ZacH005/CPS-LabyrinTUM/calibration/CharUco_2.png

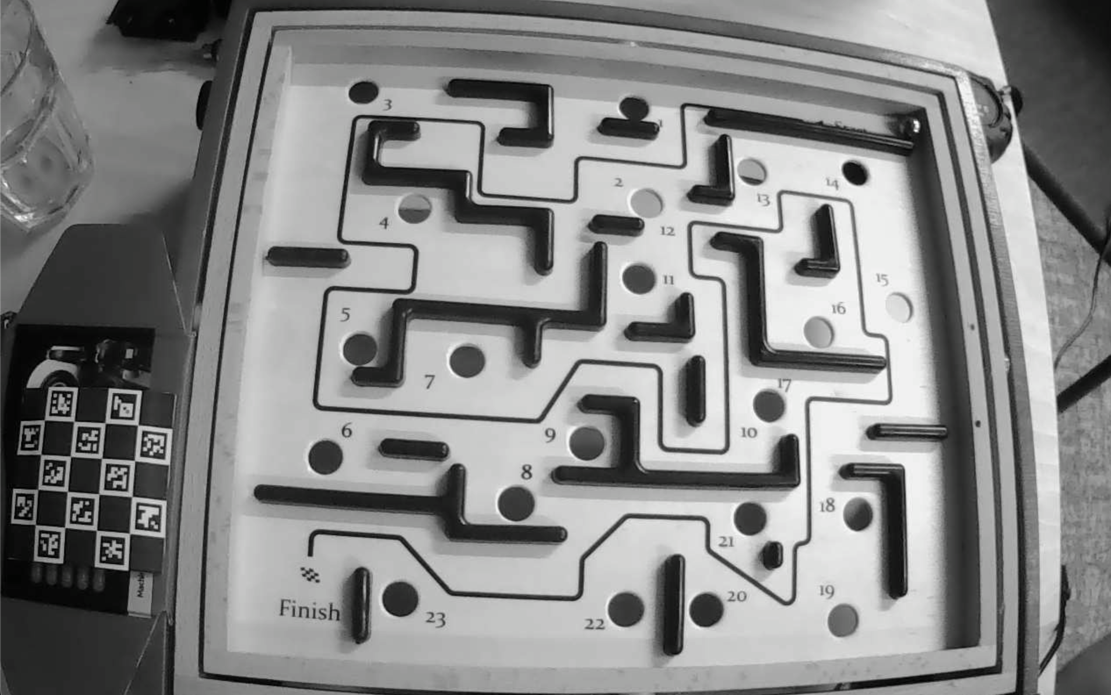
calibration/CharUco_2.png
