ZacH005/CPS-LabyrinTUM/calibration/CharUco_4.png

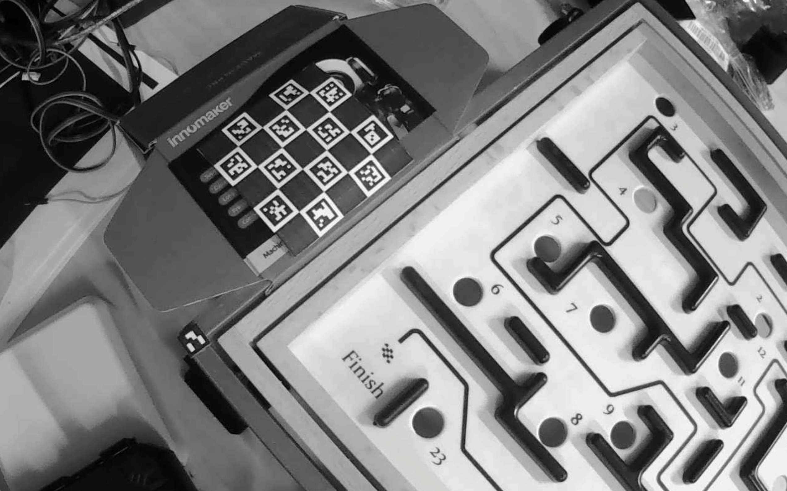
calibration/CharUco_4.png
