ZacH005/CPS-LabyrinTUM/notebooks/README.md

# Notebooks

Use notebooks only for calibration exploration, data analysis, and plotting.

Core runtime logic should live in `src/cps_maze/` so it can be tested and reused by scripts.
