ZacH005/CPS-LabyrinTUM/data/raw/README.md

# Raw Data

Use this folder for raw videos, unmodified camera captures, and first-pass run logs.

Large files should not be committed unless explicitly needed for a small reproducible example.
