ZacH005/CPS-LabyrinTUM/calibration/README.md

# Calibration Files

Store generated calibration files here.

Expected files later:

- `camera_intrinsics.npz` - camera matrix and distortion coefficients.
- `board_homography.npz` - image-to-board coordinate transform.
- `marker_points.csv` - selected image and board reference points.

These generated files are ignored by Git by default because they are machine/setup specific.
