ZacH005/CPS-LabyrinTUM/docs/TUNING_ROADMAP.md

# Moved

This roadmap was merged into the single project roadmap:

**[docs/LIVE_MVP_DEVELOPMENT_ROADMAP.md](LIVE_MVP_DEVELOPMENT_ROADMAP.md)**

Part 1 there records the completed MVP bring-up stages; Part 2 is the active
tuning roadmap (formerly this file), with commands and per-stage success
criteria.
