ZacH005/CPS-LabyrinTUM/calibration/example_marker_points.csv

x_px | y_px | x_mm | y_mm
240.9 | 1495.9 | 0 | 0
634.8 | 1450.3 | 600 | 0
569.1 | 1035.6 | 600 | 600
193.0 | 1094.3 | 0 | 600
