ZacH005/CPS-LabyrinTUM/calibration/refresh_backup_20260711_174203/configs/maze_holes.csv

x_mm | y_mm | radius_mm
209.4 | 204.8 | 4.9
157.9 | 201.0 | 4.9
129.4 | 201.0 | 5.2
55.5 | 198.1 | 4.8
174.5 | 169.9 | 5.6
217.1 | 167.8 | 5.5
90.9 | 167.0 | 5.6
27.6 | 153.8 | 5.1
114.7 | 145.8 | 5.7
183.6 | 129.0 | 5.7
71.7 | 118.0 | 5.5
35.2 | 115.7 | 5.4
206.2 | 99.4 | 5.6
242.1 | 86.8 | 5.4
134.2 | 82.6 | 5.9
50.2 | 61.0 | 5.6
138.1 | 50.9 | 5.8
182.9 | 33.3 | 5.8
228.7 | 29.2 | 5.5
29.7 | 13.7 | 5.4
134.8 | 9.3 | 5.7
