ZacH005/CPS-LabyrinTUM/calibration/refresh_backup_20260711_190709/configs/maze_holes.csv

x_mm | y_mm | radius_mm
207.3 | 200.4 | 5.1
156.9 | 196.4 | 5.2
129.0 | 196.4 | 5.4
56.9 | 193.3 | 5.2
173.0 | 165.9 | 5.5
214.7 | 164.2 | 5.4
91.3 | 162.7 | 5.6
30.2 | 149.2 | 5.4
114.5 | 141.7 | 5.6
181.5 | 125.8 | 5.6
72.7 | 114.9 | 5.6
37.6 | 112.5 | 5.5
203.3 | 96.9 | 5.6
238.2 | 84.9 | 5.5
133.2 | 80.4 | 5.8
52.3 | 59.6 | 5.6
136.9 | 50.0 | 5.8
180.1 | 32.9 | 5.7
224.5 | 29.3 | 5.4
33.0 | 14.7 | 5.5
133.4 | 9.9 | 5.7
