ZacH005/CPS-LabyrinTUM/calibration/refresh_backup_20260711_191825/configs/maze_holes.csv

x_mm | y_mm | radius_mm
206.5 | 198.9 | 5.0
156.7 | 195.1 | 5.2
129.0 | 195.1 | 5.4
57.4 | 192.8 | 5.1
172.9 | 165.2 | 5.4
214.2 | 163.1 | 5.4
91.7 | 162.3 | 5.6
30.4 | 149.4 | 5.4
114.8 | 141.5 | 5.7
181.4 | 125.2 | 5.6
73.2 | 114.8 | 5.5
38.2 | 112.6 | 5.4
203.2 | 96.6 | 5.6
237.9 | 84.5 | 4.9
133.7 | 80.3 | 5.8
53.1 | 59.8 | 5.5
137.6 | 49.8 | 5.7
180.8 | 32.7 | 5.6
224.8 | 29.2 | 5.3
33.7 | 14.6 | 5.4
134.3 | 9.8 | 5.6
