ZacH005/CPS-LabyrinTUM/calibration/refresh_backup_20260711_225427/configs/maze_holes.csv

x_mm | y_mm | radius_mm
204.1 | 201.5 | 5.3
153.8 | 197.3 | 5.5
126.3 | 197.3 | 5.5
55.3 | 193.8 | 5.2
169.8 | 167.8 | 5.6
211.5 | 165.8 | 5.4
88.9 | 164.2 | 5.5
29.8 | 150.5 | 5.1
111.6 | 143.6 | 5.6
178.2 | 128.1 | 5.6
70.7 | 117.2 | 5.4
36.5 | 114.8 | 5.2
199.8 | 99.5 | 5.5
130.1 | 83.3 | 5.6
51.1 | 63.0 | 5.4
134.0 | 53.3 | 5.6
177.0 | 36.1 | 5.6
221.2 | 32.4 | 5.2
32.6 | 18.9 | 5.0
130.6 | 15.0 | 5.1
235.6 | 87.8 | 8.0
