ZacH005/CPS-LabyrinTUM/calibration/Charuco_1.png

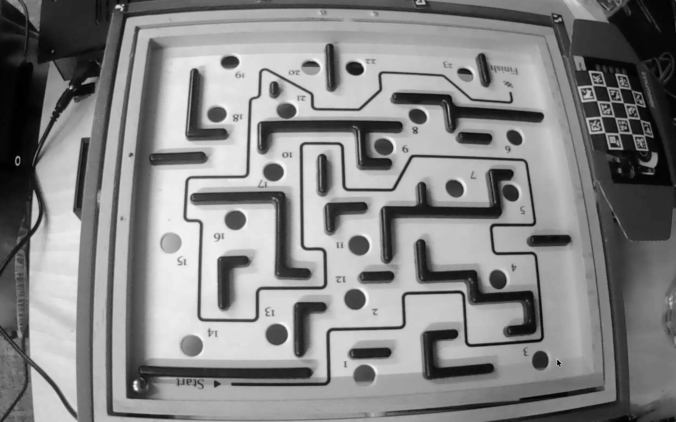
calibration/Charuco_1.png
