ZacH005/CPS-LabyrinTUM/calibration/CharUco_3.png

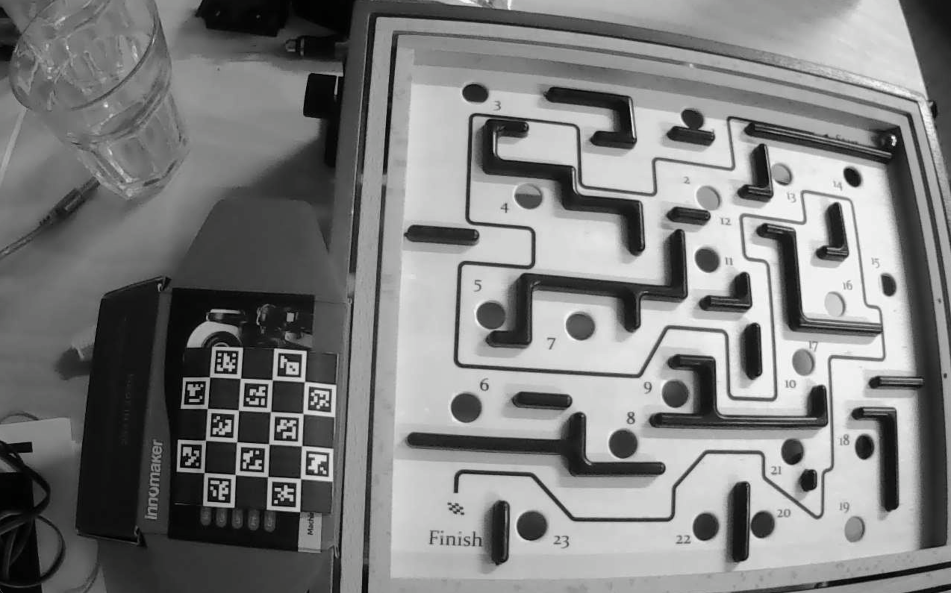
calibration/CharUco_3.png
