ZacH005/CPS-LabyrinTUM/calibration/CharUco_5.png

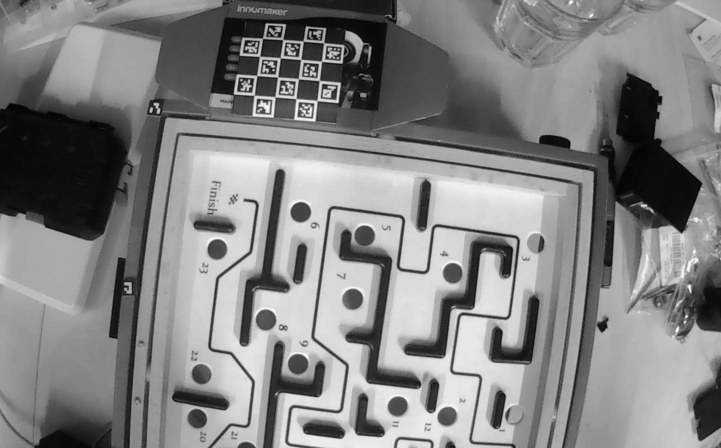
calibration/CharUco_5.png
