ZacH005/CPS-LabyrinTUM/calibration/CharUco_6.png

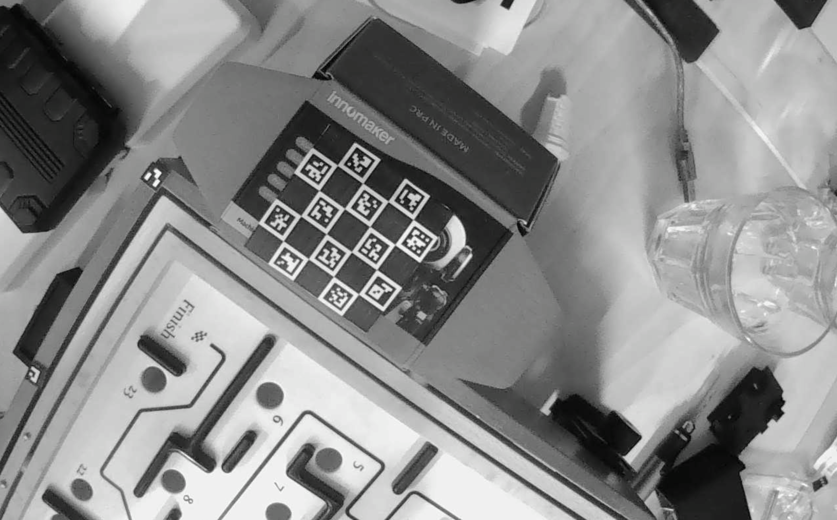
calibration/CharUco_6.png
