ZacH005/CPS-LabyrinTUM/calibration/CharUco_7.png

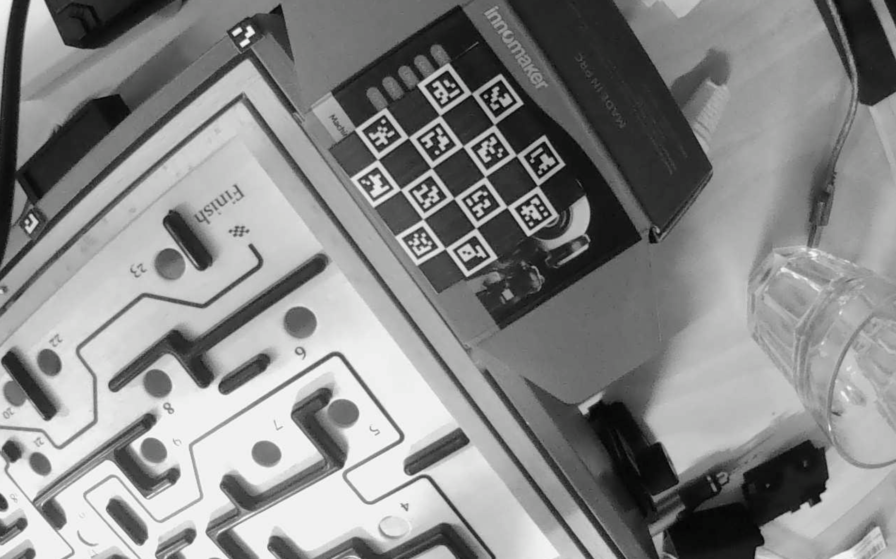
calibration/CharUco_7.png
