ZacH005/CPS-LabyrinTUM/calibration/CharUco_8.png

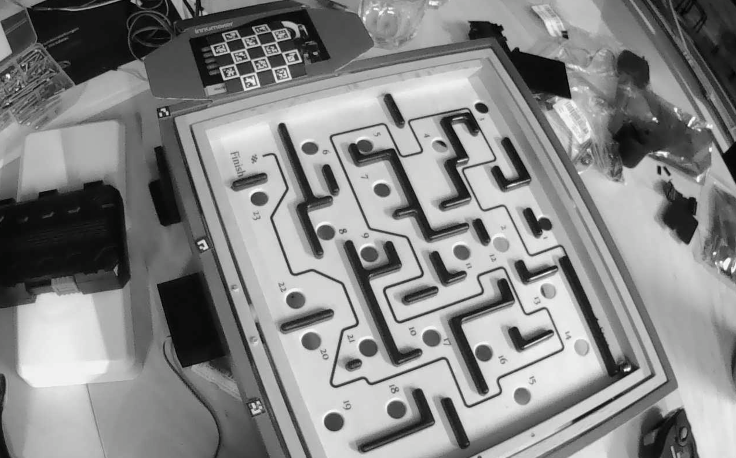
calibration/CharUco_8.png
