ZacH005/CPS-LabyrinTUM/calibration/CharUco_9.png

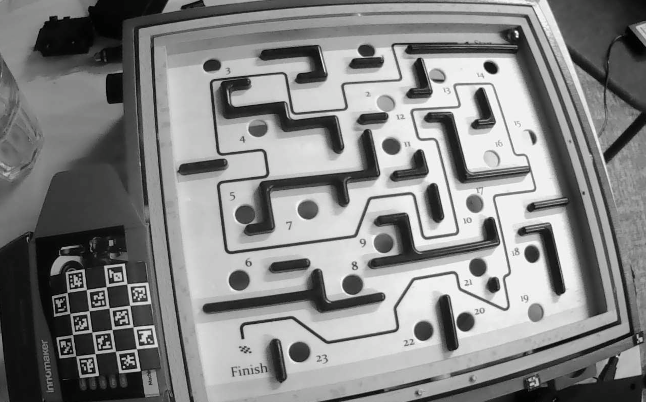
calibration/CharUco_9.png
