ZacH005/CPS-LabyrinTUM/calibration/charuco_board.png

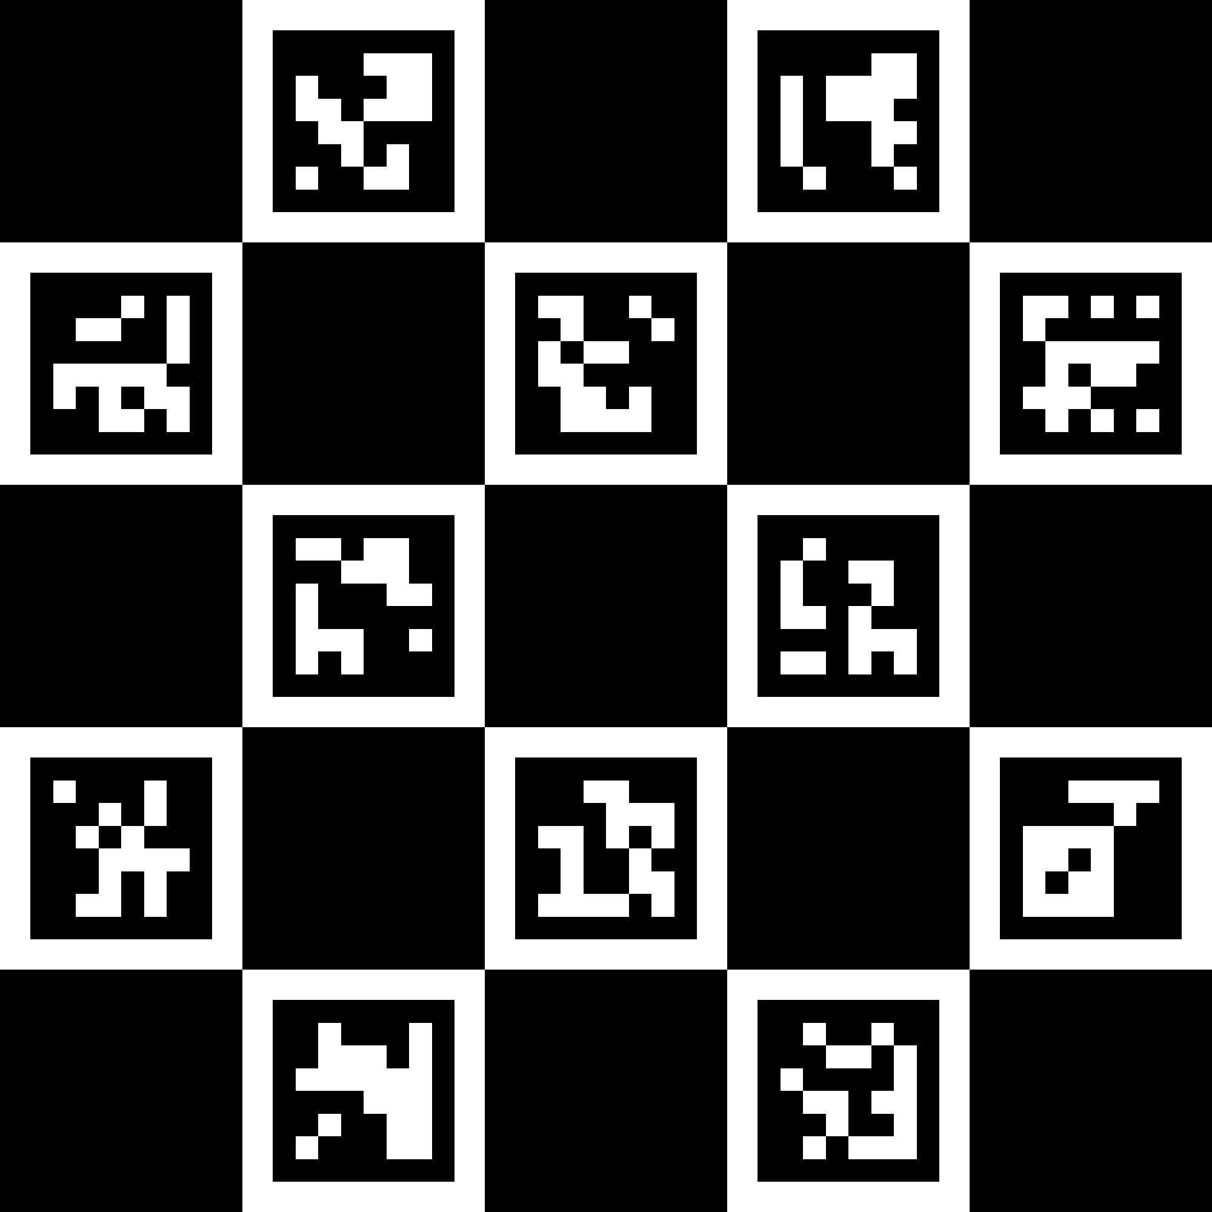
calibration/charuco_board.png
