ZacH005/CPS-LabyrinTUM/(commit log)

2026-06-16 init and repo structure
    [example_marker_points.csv, example_path.csv]
2026-07-04 Update calibration data and add image display script for board calibration
    [example_marker_points.csv]
2026-07-06 Fix ChArUco frame: y-down, flat-on-surface placement, CLI offsets
    - charuco.py: y now grows down, matching the corner-click calibration
    frame, so the two calibrations produce interchangeable coordinates;
    the pattern must lie flat on the play surface (a homography is only
    valid for points in one plane - the old side-platform mount broke it)
    - calibrate_charuco_homography.py: --pattern-x-mm/--pattern-y-mm set
    where the pattern sits relative to the play-area corner; default
    (0,0) anchors the frame at the pattern, still valid for all tools
    - auto_detect_holes.py: draw the board-frame outline and live mm mouse
    readout so the active calibration is visible at a glance
    - tests updated to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
2026-07-07 Fix hole detection inside closed border ring; clip to board bounds
    At high thresholds the board border becomes a closed white ring in the
    mask, and RETR_EXTERNAL drops every contour enclosed by it - exactly
    when dim/gray holes finally become visible. Switch to RETR_LIST (with
    center-distance de-duplication for outer+inner contours of one blob)
    and reject detections outside the board rectangle plus margin, so
    off-board junk from the auto-fit view can no longer appear as holes.
2026-07-09 Update annotated holes and auto-traced path from lab session
    [maze_holes.csv, maze_path_auto.csv]
2026-07-09 Add click-to-seed, cursor brightness readout, and in-pulse tracking
    On the bright white board several glints rival the ball, so auto-seed
    can lock onto a wall reflection and stay there. Fixes:
    - PipelineBallTracker.seed(): manual (re)seed from a user click
    - axis_check: live preview while waiting (click the ball to seed, peak
    brightness shown under the cursor to choose min_specular from real
    pixel values instead of guessing), and frames keep feeding the
    tracker during the servo pulse so the track survives the motion
    - run_autonomous: click the preview at any time to (re)seed the track
2026-07-09 Point maze.path_file at the real traced route, not the scaffold dummy
2026-07-09 Add stiction compensation and integral action to the path follower
    Pure PD has a stable parked equilibrium on this rig: near the target
    the command drops below the tilt that breaks static friction
    (~0.25-0.4 measured via axis_check), so the ball balances and stops -
    observed in the first closed-loop runs. Changes:
    - PathFollower: optional integral term with clamping anti-windup and
    bleed-off at the target, plus a stall kick that scales the command
    up to a minimum magnitude whenever the ball is stalled off-target
    - run_autonomous: passes dt, config/CLI for ki and --stall-kick
    - default.yaml: enable ki=0.004, stall_kick=0.30, lookahead 18mm,
    max_command 0.45 as the new tuned baseline
    -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
    [default.yaml]
2026-07-09 Update holes and path CSVs from lab session
    [maze_holes.csv, maze_path_auto.csv]
2026-07-09 Fix path association snapping to adjacent corridors behind walls
    The maze path snakes, so corridors far apart in path order sit
    millimetres apart physically. Global nearest-segment projection could
    associate the ball with a future/past corridor across a wall, sending
    the lookahead target - and the controller - into the wall between
    them (observed in closed-loop runs).
    WaypointPath now supports windowed projection around the last known
    progress (the ball cannot teleport along the path between frames),
    returning (progress, cross-track). run_autonomous tracks the progress
    estimate, resets it on click-reseed, and falls back to a global search
    when the windowed match is >35mm off-path (ball move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
2026-07-09 Warn when max-command is below stall_kick (kick gets clipped away)
2026-07-09 Add velocity-tracking path follower with corner braking
    Board tilt commands the ball's acceleration, so position-PD cannot
    model momentum: it carries speed into corners (12.7mm overshoot in the
    friction sim) and, with the stall kick, produces jerky bang-bang
    commands - both observed in closed-loop runs (ball thrown into holes,
    board snapping).
    New default controller tracks a desired VELOCITY along the path
    tangent: cruise speed scales down with the path's heading change ahead
    (brakes before corners), a capped lateral term pulls toward the
    centerline, and tilt corrects velocity error - so an over-fast ball
    automatically gets reverse tilt. Stall kick preserved for breakaway.
    - path.py: tange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
    [default.yaml]
2026-07-09 u gay bru
    [maze_holes.csv, maze_path_auto.csv]
2026-07-10 Refactor control system to implement carrot-based path following
    - Updated default.yaml to change control mode to "carrot" and adjusted parameters for improved cornering and velocity control.
    - Introduced CarrotVelocityFollower and associated configurations in pid.py for enhanced path following behavior.
    - Modified run_autonomous.py to support the new carrot mode, including lookahead point selection and command generation.
    - Updated tests to validate the functionality of the carrot follower and its behavior during cornering and stalling conditions.
    - Adjusted maze_holes.csv and maze_path_auto.csv for better alignment with the new control logic.
    [maze_holes.csv, maze_path_auto.csv]
2026-07-10 Add tracking debugger; fix stall-kick jitter with hysteresis + escalation
    Two field issues addressed:
    1. "Loses the ball randomly": the tracker now records per-frame
    diagnostics (candidate counts per cue, rejections per gate, glint
    brightness at the track, template score/rescues). New
    scripts/debug_tracking.py shows them live, logs every track drop
    with its dominant reason, lets min_specular be adjusted live via
    trackbar, and prints an exit report with a data-driven recommended
    threshold (p5 of the ball's real glint minus margin).
    2. "Board jitters but the ball stays balanced": the stall-kick timer
    hard-reset whenever the noisy velocity estimate flickered above the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
    [default.yaml]
2026-07-10 Fix fast-motion ball loss and near-constant corner crawling
    Field findings from the tracking debugger (85% detection, drops on fast
    motion) plus analysis of the real traced path:
    1. Fast motion loss: the control loop runs well below the camera's
    120fps, so a fast roll moves the ball 40-60px between PROCESSED
    frames - past the jump gates tuned in px/frame. Gates widened
    (max_jump 35->60, search 60->120, single-frame 45->90, velocity
    clamp 35->70). The debugger now displays live loop fps and px/frame
    jump, and reports their distribution so gates can be set from data.
    2. Motion blur dims the glint exactly when the ball moves fast
    (observed: 243 static, dips to ~194 moving) -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
    [default.yaml]
2026-07-10 ball detection
    [maze_holes.csv, maze_path_auto.csv]
2026-07-10 Fix the invisible wall: emergency brake only fires for real run-offs
    Field finding: the ball got stuck shaking between two close holes (or
    circling near one) as if behind an invisible wall. Cause: the route
    legitimately threads between holes whose CAPTURE ZONES overlap the
    centerline, so a ball rolling along the route there always "enters a
    capture zone" - the emergency brake fired, the stall kick pushed, the
    brake fired again: a limit cycle that blocks the pass entirely.
    should_emergency_brake() gates the reactive brake: it never fires for a
    ball that is on the route (cross-track <= hole_emergency_offroute_mm)
    and moving along it (velocity within hole_emergency_align_deg of the
    path tangen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
    [default.yaml]
2026-07-11 Replace reactive hole caps with a precomputed route speed profile
    Root cause of the ball 'spazzing' at hole passes (confirmed frame by
    frame in the run replay): where capture zones overlap the route, the
    per-frame hazard cap pinned the crawl speed AT the stall-detection
    threshold (both 8 mm/s), so planned crawling was diagnosed as a stall,
    the kick escalated to ~0.95 and launched the ball to 70+ mm/s, the
    brake slammed it back to zero, repeat - 15 s to travel 19 mm. Three
    locally-correct mechanisms in a global limit cycle.
    The maze is static, so the speed at every point of the route is now
    decided ONCE, coherently (planning/speed_profile.py): local limits per
    sample (committed moderate PASS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
    [default.yaml]
2026-07-11 Enhance control parameters and introduce recovery A* path planning
    - Updated `default.yaml` to adjust control parameters for improved navigation, including increased `min_speed_frac`, `corner_slow_deg`, and modified braking commands.
    - Added new recovery A* path planning functionality in `run_autonomous.py` to assist the ball in navigating off-route situations, with parameters for wall and hole clearance.
    - Implemented logic to handle recovery scenarios based on ball position and speed, enhancing overall robustness in complex environments.
    - Ensured compatibility with existing control mechanisms while improving responsiveness and safety during autonomous runs.
    [default.yaml]
2026-07-11 Warn when the confusers file is contaminated by the ball itself
    Debug session finding: ~100 static confusers blanketing the play area,
    permanently rejecting the ball's own candidates wherever it rolled
    (status lost, miss streak 148). Cause: the confuser-calibration video
    was recorded WITH the ball on the board, so every spot where the ball
    lingered >10% of the recording blacklisted itself.
    The live tracker now warns loudly when an implausible number of
    confusers loads (>30; a healthy board has ~5-15) with the exact
    remediation, and pipeline.py --calibrate documents the no-ball rule.
2026-07-11 Add neutral trim calibration: find the command where the board is level
    The table/frame is slanted, so servo neutral is not a level board: a
    resting ball drifts and the controller wastes integral headroom
    fighting a constant bias all run. The ball itself is now used as the
    level sensor.
    - scripts/calibrate_neutral_trim.py: two phases. Phase 1 nulls the
    drift (measure drift velocity over a window while streaming the
    candidate trim, step against it through the measured axis map,
    repeat until still twice in a row). Phase 2 centers the stiction
    band: friction leaves a whole band of trims where the ball is still
    even though the board is not level, so each axis is probed outward
    to th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
    [serial_link.py]
2026-07-11 Guard against stale wall masks; add mask rebuild to recalibrate_all
    Run forensics after tonight's move + recalibration: detection was 100%
    but the ball could not leave the start (5% progress, cross-track
    median 24.5mm, 88% stalled). Cause: everything was recalibrated except
    the wall mask - recalibrate_all had no wall-mask step - so the old
    mask's phantom walls covered the route's first 30mm and LOS-blocked
    the ball's four nearest path candidates, forcing the association onto
    a segment 25mm away.
    - recalibrate_all now rebuilds the wall mask right after the path step
    - the runner self-checks at startup that the route centerline lies in
    free space; if >2% of it reads as wall, it warns, names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
2026-07-11 Add ABS brake ceiling: brake authority shrinks with ball speed
    Frame-by-frame forensics of the hole-2 fall: the controller braked the
    ball to a clean stop, but the braking TILT was still physically applied
    at the moment of zero speed - tilt is force, so the stopped ball
    launched backward downhill to 65 mm/s, the controller counter-braked,
    and the resulting forward/backward oscillation carried it into the
    hole (progress 127 -> 97 -> 88 in the last second).
    Braking commands in the velocity/carrot followers are now capped at
    floor + per_mm_s * speed, so the brake melts away as the ball slows
    and the board is ~flat at the stop (like ABS). Driving authority is
    unaffected. Also: per-axis slew lim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
    [default.yaml]
2026-07-11 Stop recovery A* from hijacking the carrot at ordinary corners
    Log forensics: the carrot teleported 60mm to mid-board near hole 3 and
    drove the ball back into hole 2. Two compounding causes:
    - the "wall" recovery trigger fired whenever the straight line to the
    35mm-ahead goal was blocked - true at EVERY ordinary corner, which
    the carrot's lookahead shrinking already handles. It now also
    requires the ball to actually be slow/stuck.
    - the A* treats hole capture zones as obstacles, but the route
    legitimately passes through them, so its plans detour around zones
    the ball is meant to cross - sending the carrot into open mid-board.
    Recovery targets that would INCREASE the ball's dista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
2026-07-11 Calm control near holes: anticipatory plan lookup + slow-zone cap
    Log analysis of the hole-2 failures: the ball transits hole passes at
    median 39 mm/s against a 16 mm/s plan - the purely reactive velocity
    loop only brakes after the ball is already over plan, so it arrives
    hot and the ensuing corrections are violent (command p90 0.91, ~1
    direction reversal per second). Two changes:
    - the planned speed is now read where the ball WILL be in
    plan_latency_s (0.35 s), so deceleration into slow zones starts
    early and the ball glides in at pass speed
    - inside slow zones (profile_scale < 0.75) command magnitude is capped
    at slowzone_max_command (0.55, emergency exempt): near holes the
    contro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
    [default.yaml]
2026-07-11 StallKicker: accumulate at half rate inside the noise band
    The hysteresis band held the stall timer instead of resetting it - but
    holding at ZERO forever means a parked ball whose velocity-estimate
    noise floor sits inside the band (observed: ~5-9 mm/s while physically
    stopped) never builds stall time and never gets kicked. Tonight's
    143 s run spent 45 s in two stalls at path 69 mm with commands of only
    0.11-0.16 for exactly this reason; when the ball finally broke out at
    t=142 the stored tilt launched it 4 -> 80 mm/s into hole 3.
    The band now accumulates at half rate: noise still cannot RESET the
    timer (the band's purpose), but a genuinely parked ball always reaches
    the kick threshold. 69 t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
2026-07-11 Add composure state: stabilize after violence before resuming progress
    Observed cascade at hole 1: near-miss -> rough brake -> ball too fast
    -> unstable -> the follower demanded forward progress anyway -> fell.
    The controller had no notion of composure: the instant an emergency
    ended it resumed pursuing the plan while the ball was still ringing,
    feeding the oscillation.
    New stabilize state: entered when the emergency brake fires or speed
    exceeds max(2x plan, plan + 20 mm/s). While active the objective is
    NOT progress - hold the entry position with damped position control
    (speed-capped so the hold itself cannot slam), and only after the
    ball has been still for stabilize_still_s (or a 3 s tim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
2026-07-11 Add MJPG negotiation probe: decide fps fix vs recalibration
    The fps probe showed the camera stays on uncompressed YUY2 (10 fps at
    1280x800, 30 fps only at 640x480). Whether we can fix the frame rate WITHOUT
    recalibrating hinges on one question: can this camera negotiate MJPG at full
    resolution? MJPG negotiation over OpenCV is sensitive to backend and set()
    order, so this tries the full matrix (DSHOW/MSMF x 3 orders x 2 resolutions)
    and reports the negotiated fourcc + measured fps for each. If any 1280x800 row
    comes back MJPG+fast we fix camera.py with no recalibration; if not, we drop
    to 640x480 and recalibrate.
2026-07-11 Camera: default to MSMF on Windows for 120fps at 1280x800 (was 10fps)
    Root cause of the 'can't stabilize' control loop: the camera was opened
    through DirectShow, which on the lab rig only exposes the uncompressed YUY2
    mode - USB2 bandwidth caps that at ~10 fps at 1280x800. The probe matrix
    (scripts/probe_camera_mjpg.py) showed MSMF negotiates the camera's native
    high-speed mode and delivers the FULL 120 fps at 1280x800, with no resolution
    drop and no recalibration. The camera was always a 120fps camera; the backend
    was the bottleneck.
    Switch the Windows auto-backend from DSHOW to MSMF. The only cost is a slower
    one-time open (~10-30 s), irrelevant to the run loop. Non-Windows is
    unchanged (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
2026-07-12 Add teammate handoff: status, run guide, and the pitch-backlash blocker
2026-07-13 Revert control to the smooth cfade8a regime; disable unstick
    A run on cfade8a was far smoother than the current hot-gain + unstick regime:
    median command 0.28, only 5% command sign-flips, steady ~9 mm/s, no
    stabilize/unstick thrashing (96% "slow"). The current config (k_vel 0.06,
    command_slew 15, unstick on) oscillated then launched.
    The decisive difference is command_slew_per_s: 1.5 (cfade8a) vs 15. At 1.5/s
    the command is heavily low-pass filtered, so tilts are steady AND persist
    across the stall kick's on/off toggling - that held tilt is a sustained push,
    which is why cfade8a cleared corners WITHOUT unstick. The 15/s slew let the
    command collapse between twitches, so the ball stuck and u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
    [default.yaml]
2026-07-13 Finish-approach crawl: slow the whole last stretch into the goal
    Run reached the finish (prog 1134/1126) but fell at idx3, the last hole. In the
    final section the ball careened at 30-219 mm/s against an 8 mm/s plan, bouncing
    among the three close end holes (idx1/2/3) - it arrives too hot and the route
    threads past several holes in the last ~180 mm, so any spike drops it in.
    Add finish_crawl_mm / finish_crawl_speed_mm_s to build_speed_profile: the last
    finish_crawl_mm of the route is capped at the crawl speed (below the floor), and
    the backward pass starts the deceleration well upstream so the ball eases into
    the finish under tight control instead of flying into it. Default: last 180 mm
    at 8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
    [default.yaml]
2026-07-13 Add recording configuration and functionality to autonomous run script
    - Introduced a new 'recording' section in default.yaml to enable video recording of autonomous runs, with options for output directory, views, FPS, codec, and file suffix.
    - Updated run_autonomous.py to include command-line arguments for controlling video recording settings, allowing users to specify recording options directly.
    - Integrated video recording functionality into the main execution flow, ensuring that video frames are captured alongside run data, with accurate timestamping for post-run analysis.
2026-07-13 Asymmetric danger crawl: slow BEFORE the hazard (fixes hole 5's descent)
    Three runs all fell at hole 5 (idx11) the same way. Geometry: the route goes
    straight DOWN (x=26, y 99->119) then turns sharply 76 deg at the bottom, with
    hole 5 sitting 13mm to the right in the crook. The ball accelerates down that
    descent (hit 114-222 mm/s across the three runs), can't make the bottom turn,
    and is flung right into hole 5. Unlike hole 4's flat U-turn, the symmetric
    crawl band engaged AS the descent began - too late; the ball was already hot.
    Make the danger crawl band ASYMMETRIC: start it hole_danger_band_before_mm (30)
    UPSTREAM of the hazard and hold it hole_danger_band_after_mm (12) past it, so
    the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
    [default.yaml]
2026-07-13 docs: sync paper software/struggles refs to final velocity-PI build; add report corrections
2026-07-14 Update README to enhance project clarity and detail
    - Expanded project description to provide a comprehensive overview of the CPS-LabyrinTUM system and its components.
    - Revised sections on final outcomes, features, and hardware to reflect the successful maze-solving capabilities and the system's architecture.
    - Added detailed setup instructions and calibration processes for improved user guidance.
